ToolKnox/hawkridge-simplefoc-bldc-balancing-robot/source/upstream/images/balancer.JPG

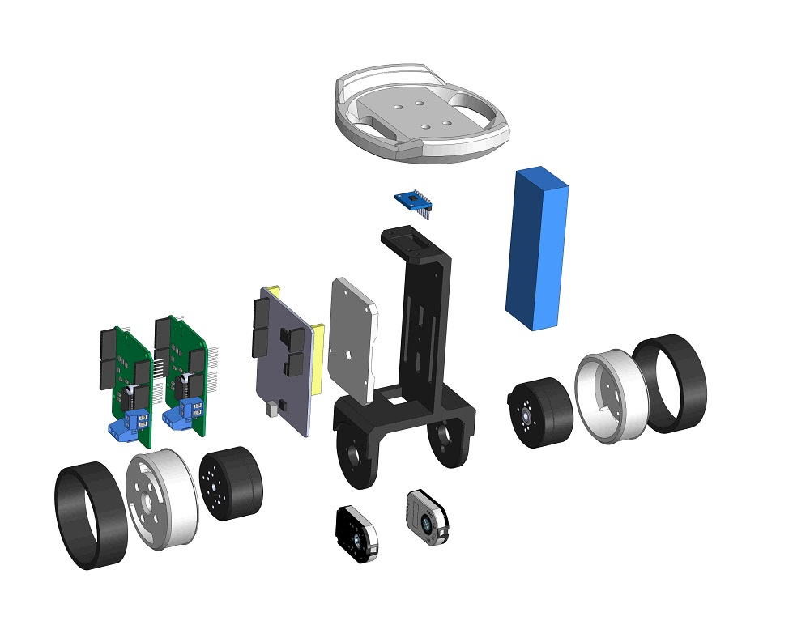
source/upstream/images/balancer.JPG
