ToolKnox/hawkridge-simplefoc-bldc-balancing-robot/source/upstream/images/balancer_exploaded.jpg

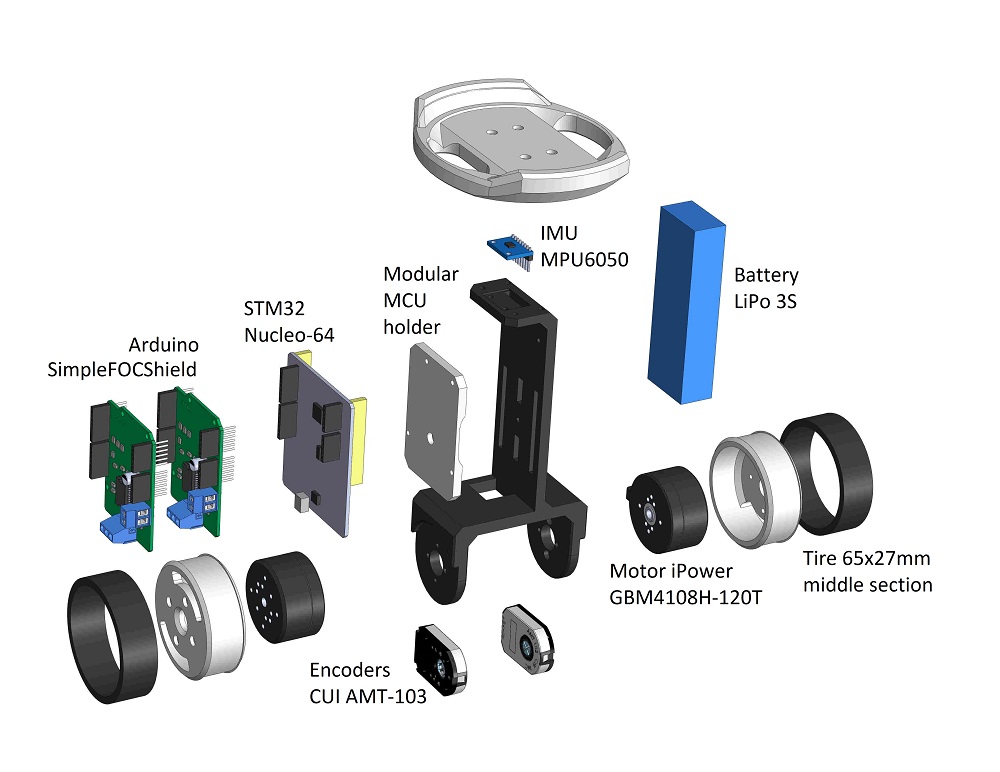
source/upstream/images/balancer_exploaded.jpg
