ToolKnox/hawkridge-simplefoc-bldc-balancing-robot/source/upstream/images/balancer_front.JPG

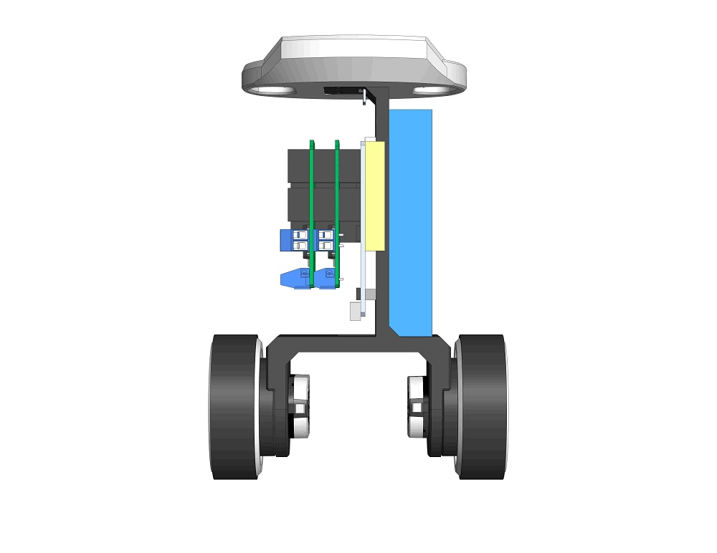
source/upstream/images/balancer_front.JPG
