ToolKnox/hawkridge-simplefoc-bldc-balancing-robot/source/upstream/images/balancer_s.JPG

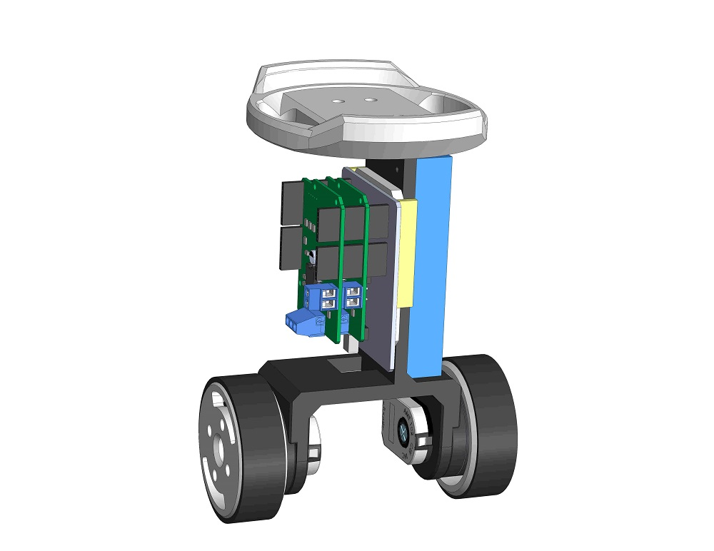
source/upstream/images/balancer_s.JPG
