ToolKnox/hawkridge-simplefoc-bldc-balancing-robot/source/upstream/images/balancer_t.JPG

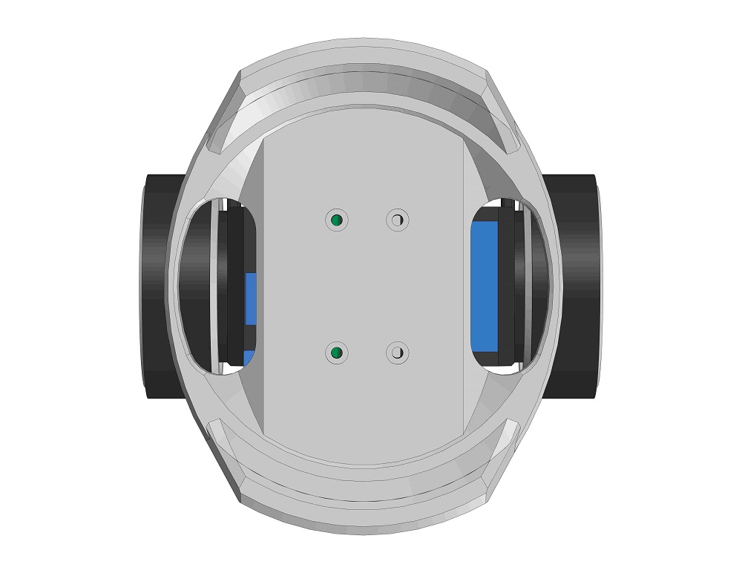
source/upstream/images/balancer_t.JPG
