ToolKnox/hawkridge-simplefoc-bldc-balancing-robot/source/upstream/images/balancer_yt.png

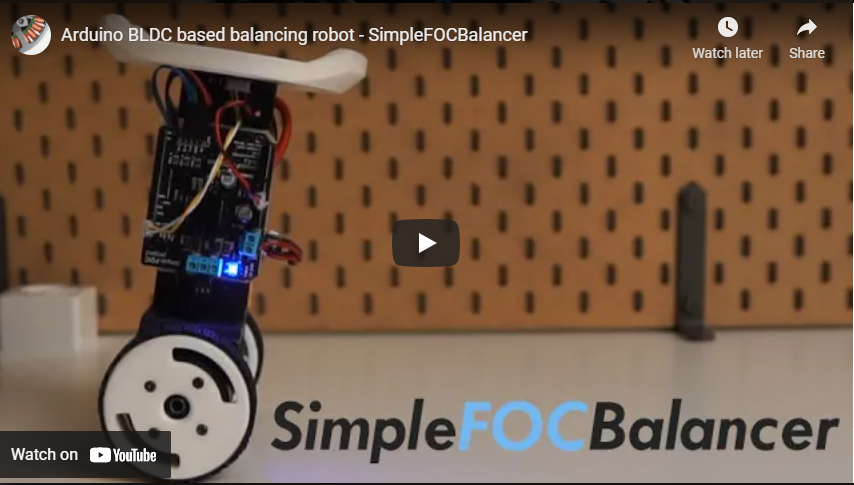
source/upstream/images/balancer_yt.png
