ToolKnox/hawkridge-simplefoc-bldc-balancing-robot/source/upstream/images/gibalo.png

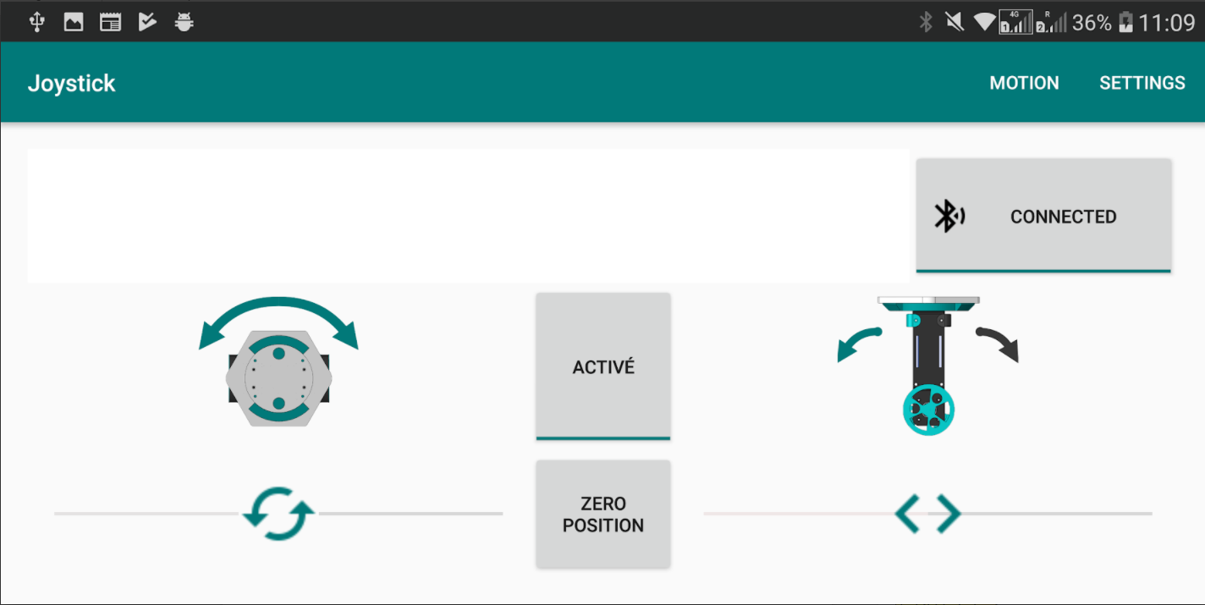
source/upstream/images/gibalo.png
