ToolKnox/hawkridge-simplefoc-bldc-balancing-robot/source/upstream/images/hc06.png

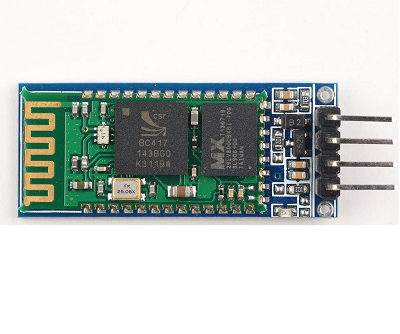
source/upstream/images/hc06.png
