ToolKnox/hawkridge-simplefoc-bldc-balancing-robot/source/upstream/images/mpu6050.jpg

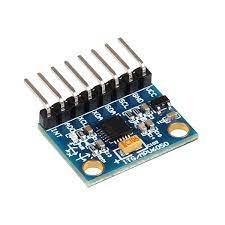
source/upstream/images/mpu6050.jpg
