ToolKnox/hawkridge-simplefoc-bldc-balancing-robot/source/upstream/images/scheme.png

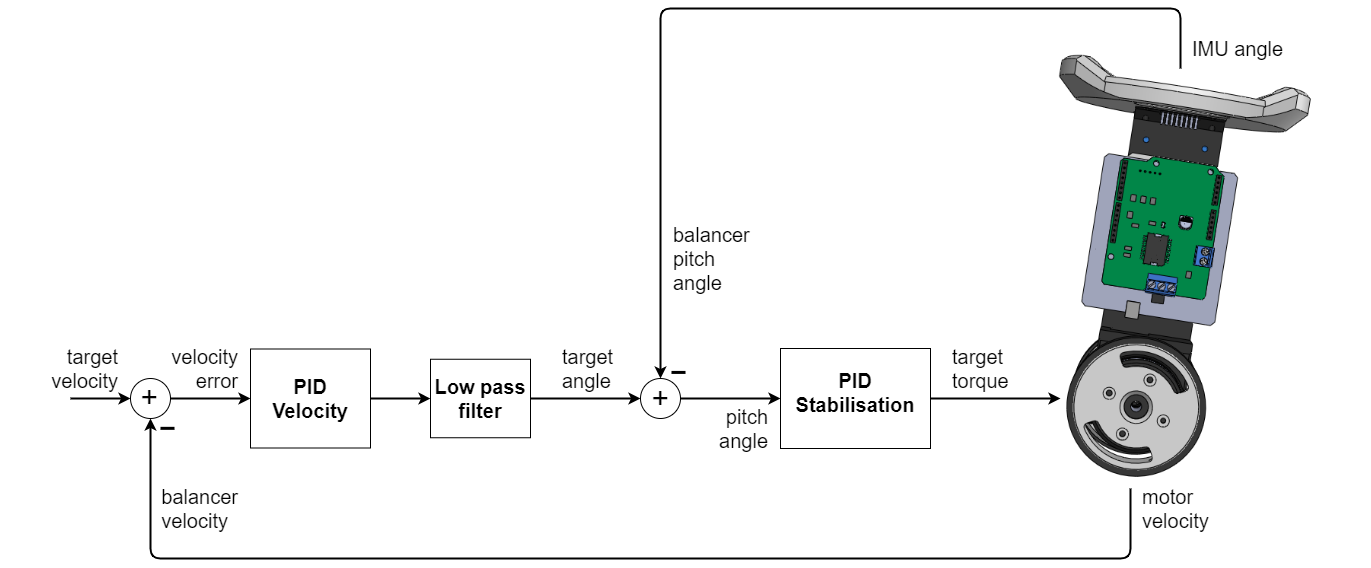
source/upstream/images/scheme.png
