ToolKnox/hawkridge-simplefoc-bldc-balancing-robot/source/upstream/images/tire.png

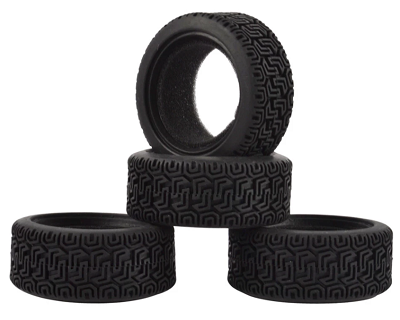
source/upstream/images/tire.png
