ToolKnox/hawkridge-simplefoc-bldc-balancing-robot/source/upstream/CAD/SolidWorks/AMT102/CUI_cui_amt102-0048-n2000-s.sldasm

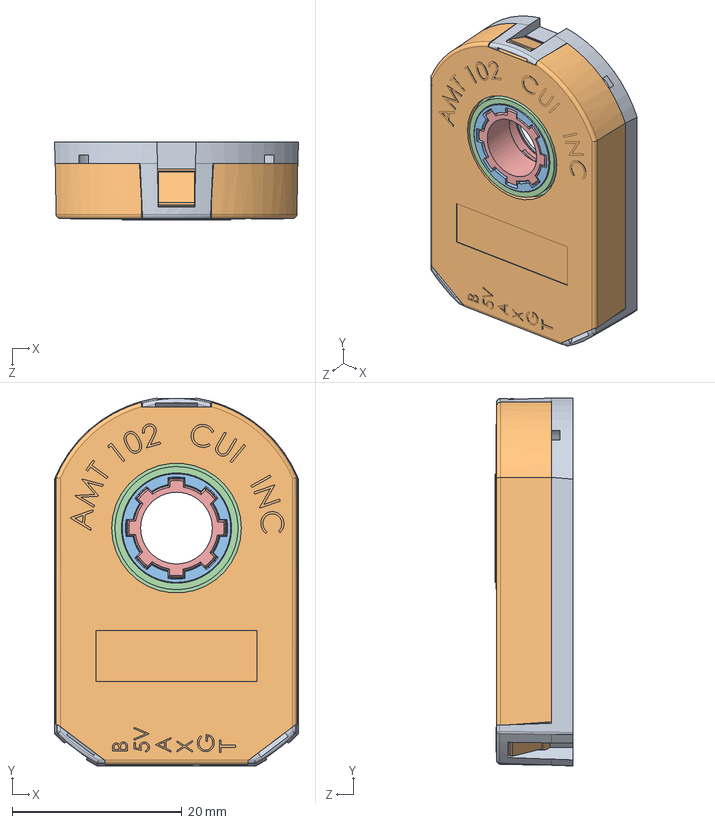
[picture p14: CAD file, 2026-10-19]
source/upstream/CAD/SolidWorks/AMT102/CUI_cui_amt102-0048-n2000-s.sldasm
28.8 x 43.4 x 9.15 mm
CUI_amt-102-base-rev-k
CUI_amt-102-top-cover-rev-h
CUI_amt-hub-top-rev-d1
CUI_amt-hub-bottom-rev-b
CUI_amt10x-shaft-adaptor-rev-e
