ToolKnox/hawkridge-simplefoc-bldc-balancing-robot/source/upstream/CAD/SolidWorks/SimpleFOCShield/ArduinoFOC.SLDASM

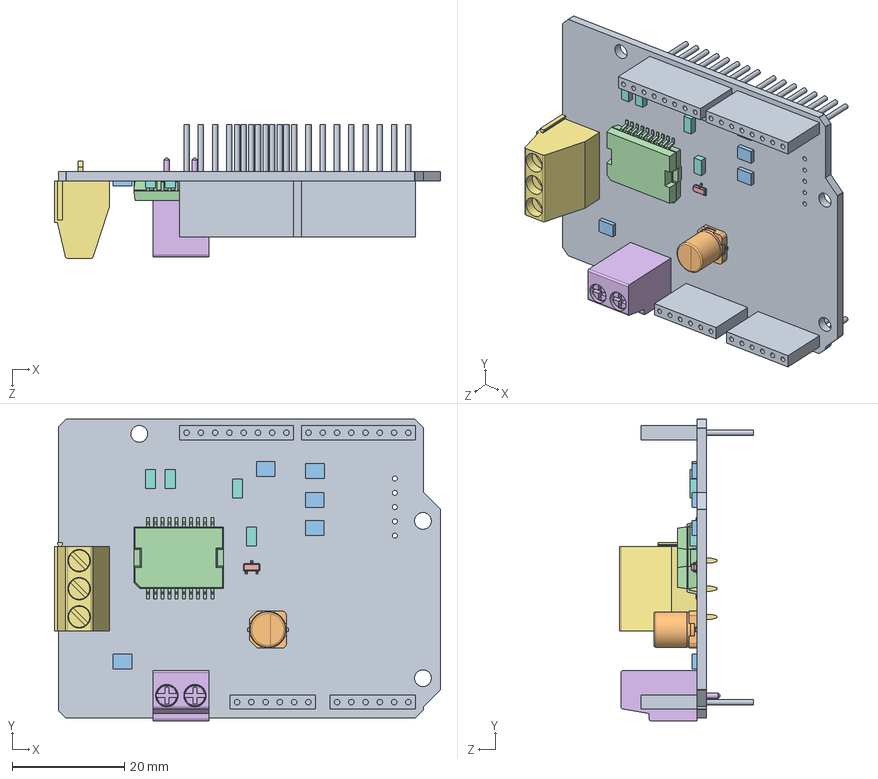
[picture p15: CAD file, 2026-10-19]
source/upstream/CAD/SolidWorks/SimpleFOCShield/ArduinoFOC.SLDASM
68.7 x 53.7 x 23.8 mm
Board
User_Library-A3D-003-00012
Extruded x 5
L6234PD x 2
User_Library-BAT54 x 2
2_RGB15238730
37753_RGB15238730
Extruded_2 x 4
headers
