ToolKnox/hawkridge-simplefoc-bldc-balancing-robot/source/upstream/CAD/SolidWorks/SimpleFOCShield/R2.sldasm

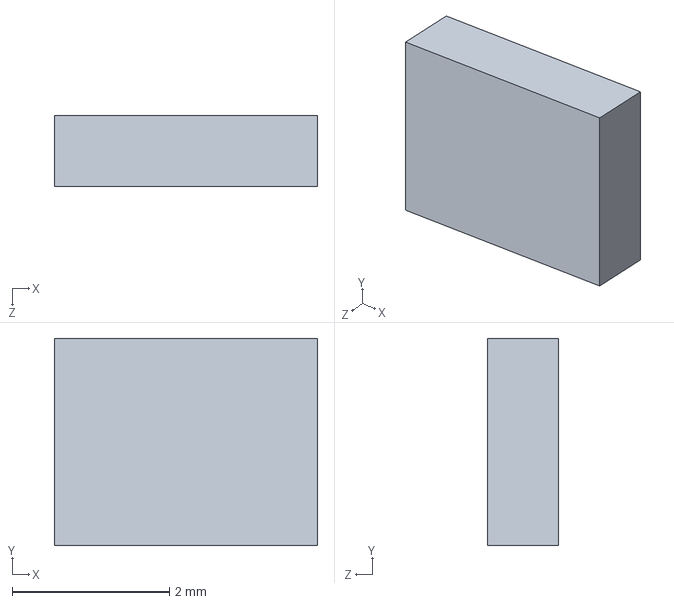
[picture p16: CAD file, 2026-10-19]
source/upstream/CAD/SolidWorks/SimpleFOCShield/R2.sldasm
3.35 x 2.64 x 0.9 mm
