ToolKnox/hawkridge-simplefoc-bldc-balancing-robot/source/upstream/Arduino/simplefoc_balancer/src/MPU6050/Examples/MPU6050_DMP6_using_DMP_V6.12/MPUplane/data/biplane.obj

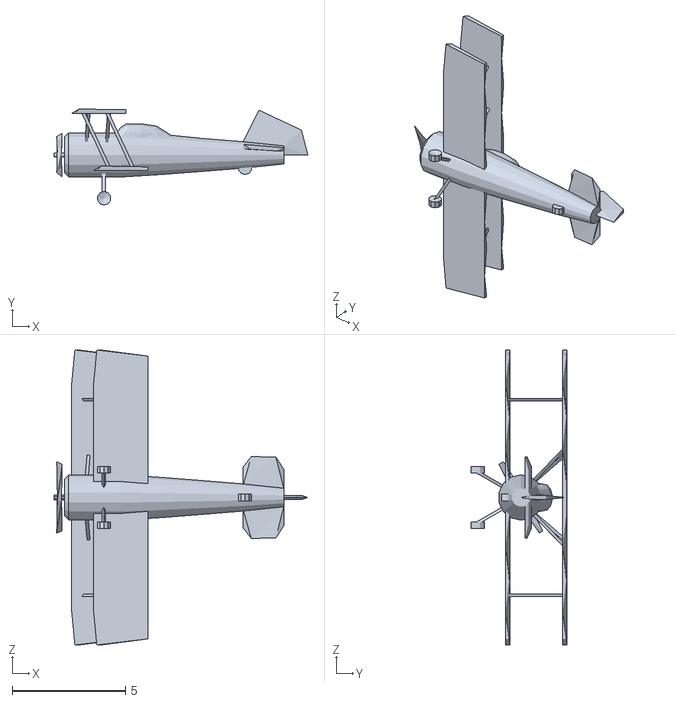
[picture p17: CAD file, 2026-10-19]
source/upstream/Arduino/simplefoc_balancer/src/MPU6050/Examples/MPU6050_DMP6_using_DMP_V6.12/MPUplane/data/biplane.obj
11.2 x 4.23 x 13.0
