ToolKnox/hawkridge-simplefoc-bldc-balancing-robot/source/upstream/CAD/SolidWorks/tire.SLDPRT

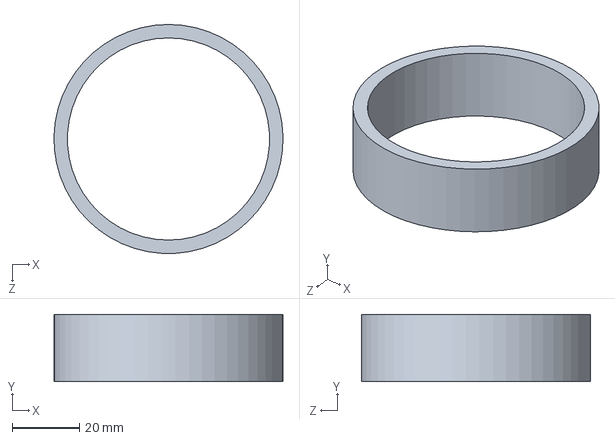
[picture p18: CAD file, 2026-10-19]
source/upstream/CAD/SolidWorks/tire.SLDPRT
68.0 x 20.0 x 68.0 mm
