ToolKnox/hawkridge-simplefoc-bldc-balancing-robot/source/upstream/CAD/STEP/balancer.STEP

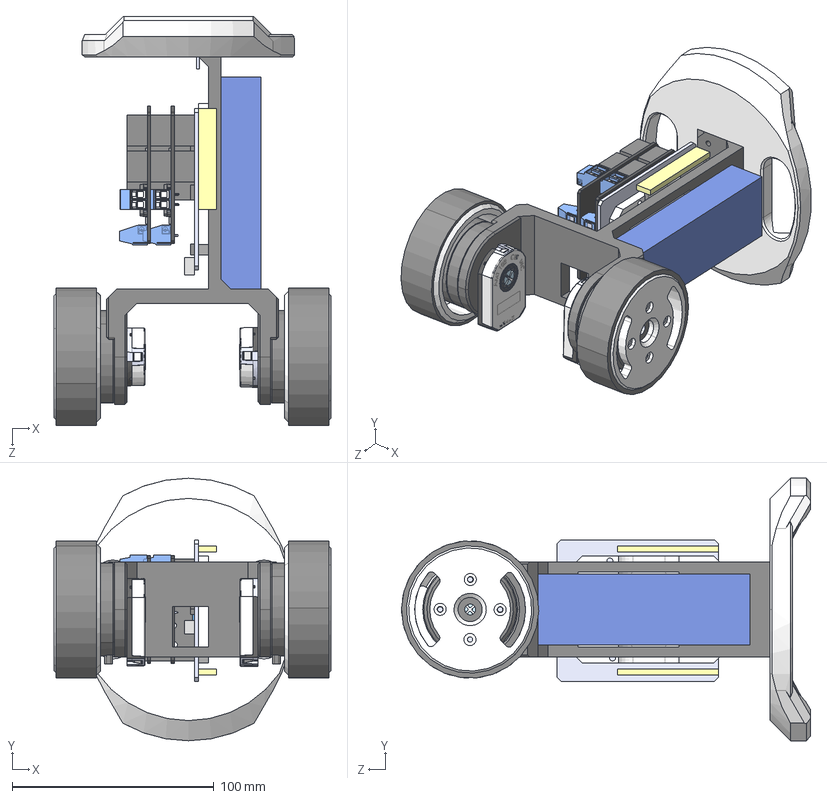
[picture p19: CAD file, 2026-10-19]
source/upstream/CAD/STEP/balancer.STEP
137.0 x 130.0 x 202.5 mm
FOC_balancer
motor x 2
CUI_amt-102-base-rev-k x 2
CUI_amt-102-top-cover-rev-h x 2
CUI_amt-sleeve-rev-d( 2 mm) x 2
CUI_amt-hub-top-rev-d1 x 2
CUI_amt-hub-bottom-rev-b x 2
CUI_amt10x-shaft-adaptor-rev-e x 2
CUI_receiver-board x 2
CUI_rotor-board-rev f x 2
CUI_transmitter-board amt10(amt-102) x 2
battery3
nucleo_foc
arduino_holder
wheel x 2
tire x 2
Board x 2
User_Library-A3D-003-00012 x 2
Extruded x 10
L6234PD x 4
User_Library-BAT54 x 4
2_RGB15238730 x 2
37753_RGB15238730 x 2
Extruded_2 x 8
headers x 2
mpu6050
top_plate
