ToolKnox/hawkridge-simplefoc-bldc-balancing-robot/source/upstream/CAD/SolidWorks/nucleo_foc.SLDPRT

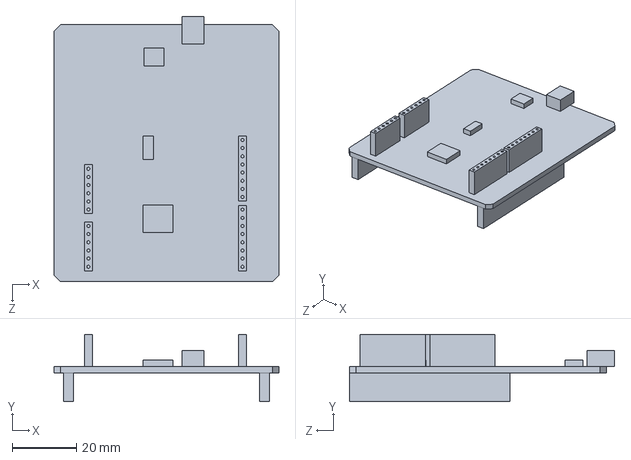
[picture p20: CAD file, 2026-10-19]
source/upstream/CAD/SolidWorks/nucleo_foc.SLDPRT
70.0 x 21.0 x 82.5 mm
