ToolKnox/hawkridge-simplefoc-bldc-balancing-robot/source/upstream/CAD/SolidWorks/battery3.SLDPRT

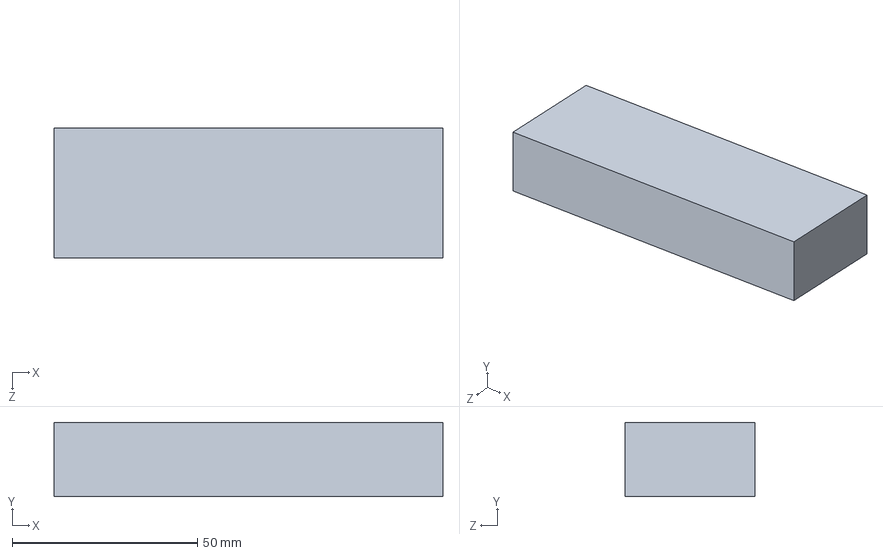
[picture p21: CAD file, 2026-10-19]
source/upstream/CAD/SolidWorks/battery3.SLDPRT
105.0 x 20.0 x 35.0 mm
