ToolKnox/hawkridge-simplefoc-bldc-balancing-robot/source/upstream/CAD/SolidWorks/arduino_holder.SLDPRT

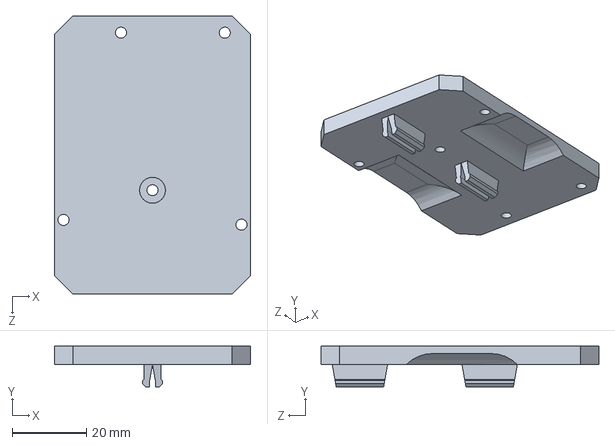
[picture p22: CAD file, 2026-10-19]
source/upstream/CAD/SolidWorks/arduino_holder.SLDPRT
53.0 x 11.0 x 75.0 mm
