ToolKnox/hawkridge-simplefoc-bldc-balancing-robot/source/upstream/CAD/SolidWorks/top_plate.SLDPRT

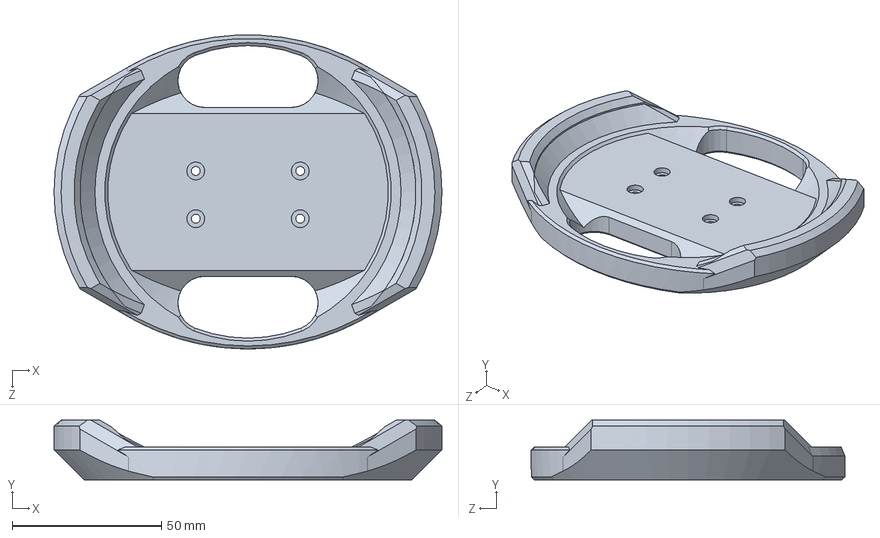
[picture p23: CAD file, 2026-10-19]
source/upstream/CAD/SolidWorks/top_plate.SLDPRT
130.0 x 20.0 x 105.2 mm
