ToolKnox/hawkridge-simplefoc-bldc-balancing-robot/source/upstream/CAD/SolidWorks/mpu6050.SLDPRT

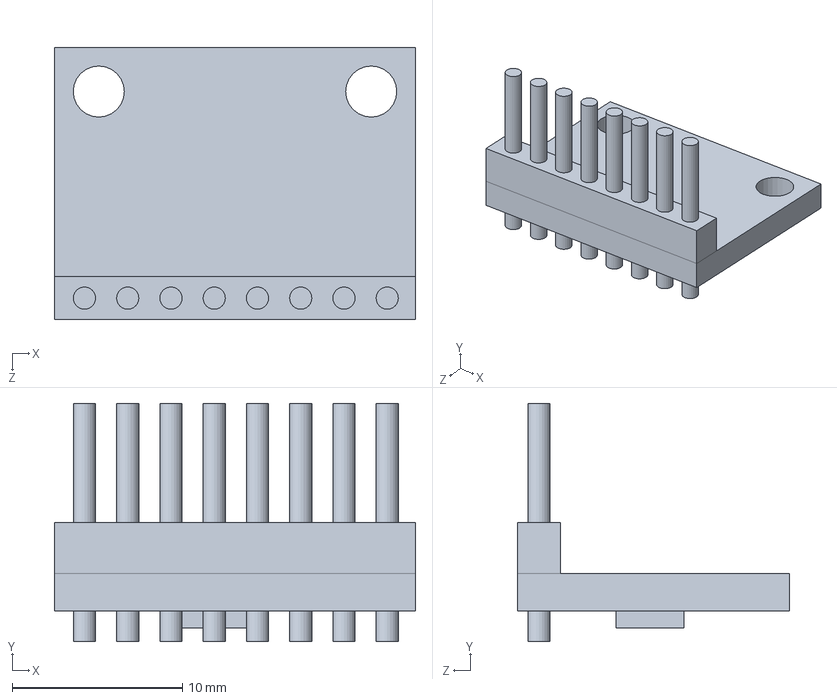
[picture p24: CAD file, 2026-10-19]
source/upstream/CAD/SolidWorks/mpu6050.SLDPRT
21.2 x 14.0 x 16.0 mm
