ToolKnox/hawkridge-simplefoc-bldc-balancing-robot/source/upstream/CAD/SolidWorks/FOC_balancer.SLDPRT

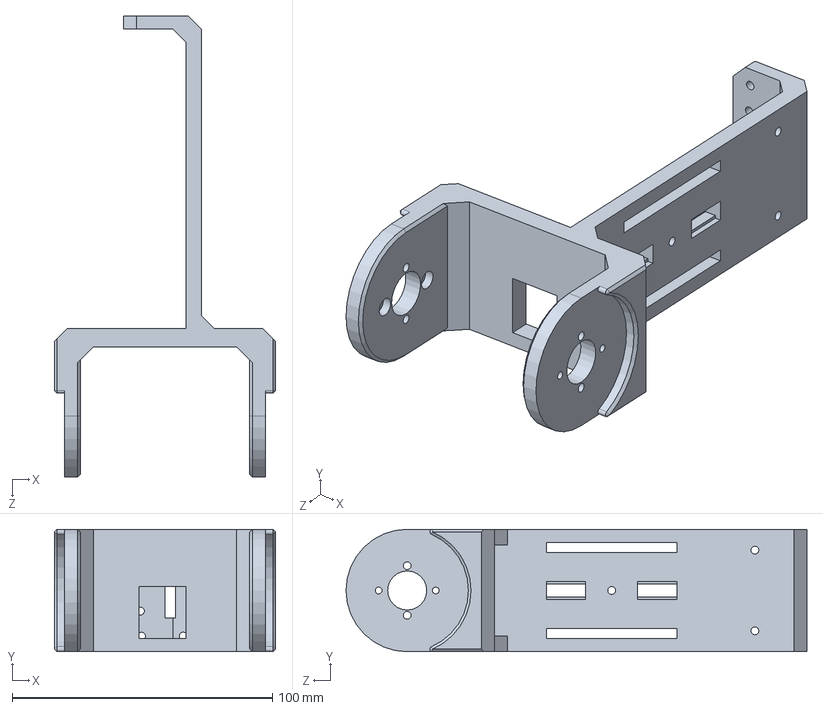
[picture p25: CAD file, 2026-10-19]
source/upstream/CAD/SolidWorks/FOC_balancer.SLDPRT
85.0 x 47.0 x 177.0 mm
