ToolKnox/hawkridge-simplefoc-bldc-balancing-robot/source/upstream/CAD/SolidWorks/wheel.SLDPRT

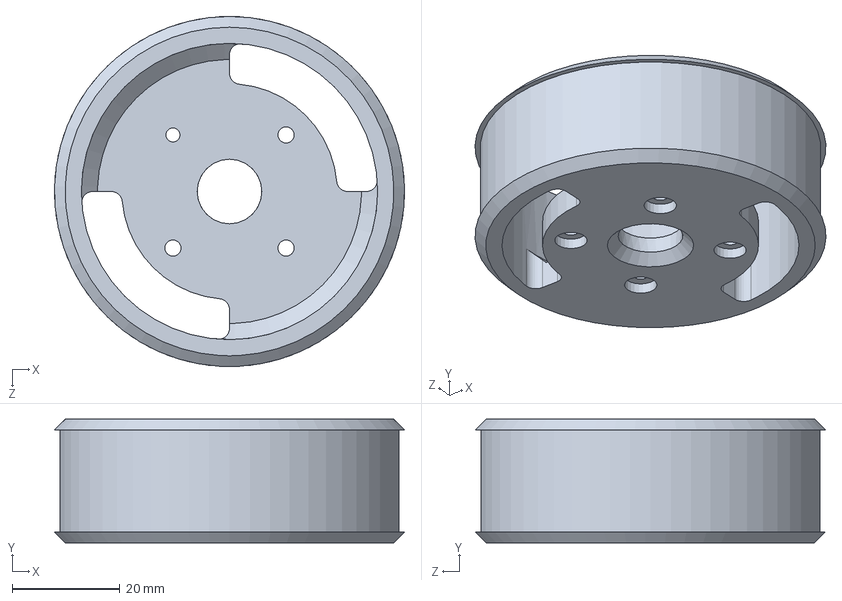
[picture p26: CAD file, 2026-10-19]
source/upstream/CAD/SolidWorks/wheel.SLDPRT
65.0 x 23.0 x 65.0 mm
