ToolKnox/hawkridge-simplefoc-bldc-balancing-robot/source/upstream/CAD/SolidWorks/motor.SLDPRT

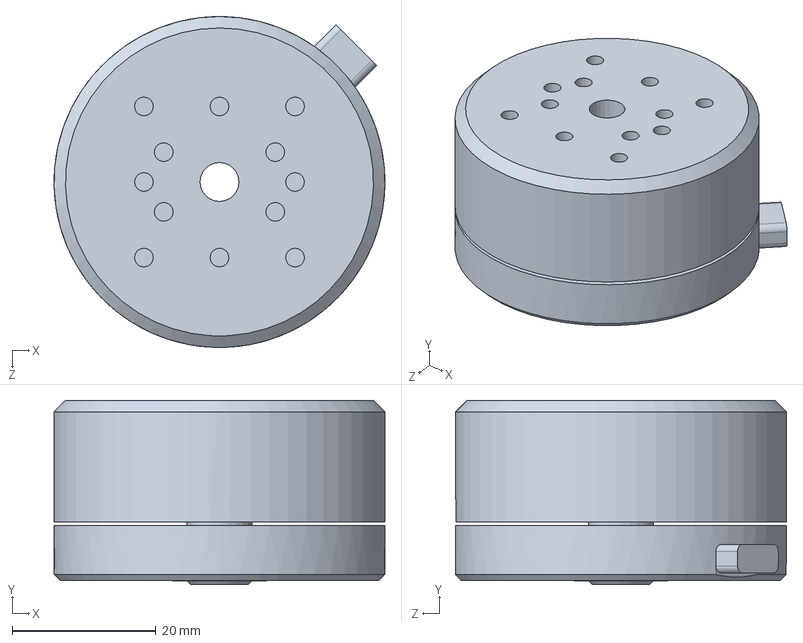
[picture p27: CAD file, 2026-10-19]
source/upstream/CAD/SolidWorks/motor.SLDPRT
46.0 x 25.6 x 46.0 mm
