ToolKnox/hawkridge-simplefoc-bldc-balancing-robot/source/upstream/CAD/SolidWorks/SimpleFOCShield/headers.SLDPRT

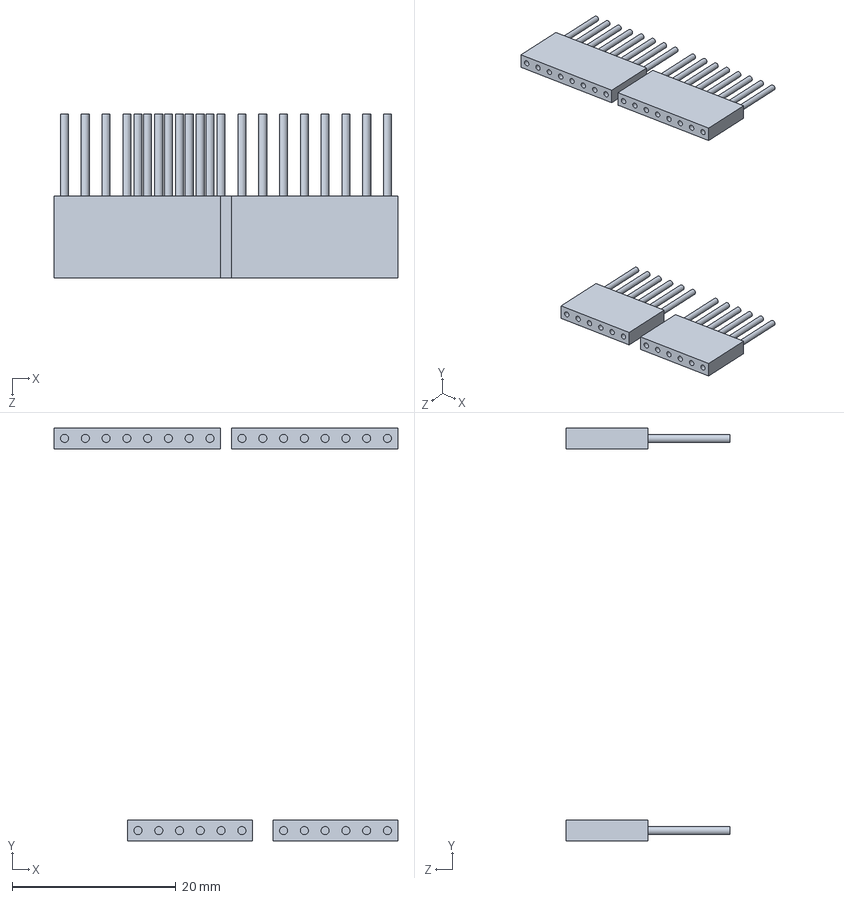
[picture p28: CAD file, 2026-10-19]
source/upstream/CAD/SolidWorks/SimpleFOCShield/headers.SLDPRT
42.0 x 50.5 x 20.0 mm
