ToolKnox/hawkridge-simplefoc-bldc-balancing-robot/(list of files, cad)

Other CAD files:
source/upstream/CAD/SolidWorks/SimpleFOCShield/C4.sldasm
source/upstream/CAD/SolidWorks/SimpleFOCShield/C2.sldasm
source/upstream/CAD/SolidWorks/SimpleFOCShield/BAT1.sldasm
source/upstream/CAD/SolidWorks/SimpleFOCShield/C3.sldasm
source/upstream/CAD/SolidWorks/SimpleFOCShield/TB_PWR.sldasm
source/upstream/CAD/SolidWorks/SimpleFOCShield/CAP1.sldasm
source/upstream/CAD/SolidWorks/SimpleFOCShield/C1.sldasm
source/upstream/CAD/SolidWorks/SimpleFOCShield/L6234.sldasm
source/upstream/CAD/SolidWorks/SimpleFOCShield/PULL_A.sldasm
source/upstream/CAD/SolidWorks/SimpleFOCShield/PULL_B.sldasm
source/upstream/CAD/SolidWorks/SimpleFOCShield/TB_M1.sldasm
source/upstream/CAD/SolidWorks/SimpleFOCShield/PULL_I.sldasm
source/upstream/CAD/SolidWorks/SimpleFOCShield/R1.sldasm
source/upstream/CAD/SolidWorks/AMT102/CUI_amt10x-shaft-adaptor-rev-e.sldprt
source/upstream/CAD/SolidWorks/SimpleFOCShield/Extruded_2.sldprt
source/upstream/CAD/SolidWorks/AMT102/CUI_amt-hub-bottom-rev-b.sldprt
source/upstream/CAD/SolidWorks/SimpleFOCShield/User_Library-A3D-003-00012.sldprt
source/upstream/CAD/SolidWorks/AMT102/CUI_amt-hub-top-rev-d1.sldprt
source/upstream/CAD/SolidWorks/SimpleFOCShield/2_RGB15238730.sldprt
source/upstream/CAD/SolidWorks/AMT102/CUI_amt-102-base-rev-k.sldprt
source/upstream/CAD/SolidWorks/SimpleFOCShield/User_Library-BAT54.sldprt
source/upstream/CAD/SolidWorks/AMT102/CUI_amt-102-top-cover-rev-h.sldprt
source/upstream/CAD/SolidWorks/SimpleFOCShield/L6234PD.sldprt
source/upstream/CAD/SolidWorks/SimpleFOCShield/Extruded.sldprt
source/upstream/CAD/SolidWorks/SimpleFOCShield/Board.sldprt
source/upstream/CAD/STL/FOC_balancer.STL
source/upstream/CAD/STL/arduino_holder.STL
source/upstream/CAD/STL/top_plate.STL
source/upstream/CAD/STL/wheel.STL
source/upstream/CAD/SolidWorks/SimpleFOCShield/37753_RGB15238730.sldprt
source/upstream/CAD/SolidWorks/SimpleFOCShield/5920131968.sldasm
source/upstream/CAD/SolidWorks/SimpleFOCShield/5920132160.sldasm
source/upstream/CAD/SolidWorks/balancer.SLDASM
